emoestudio/Single-phase-AC-electronic-load/电赛提高指标的方法.md

# 电赛目标参数

1. 降低功率到3W内
   1. 换开关频率 区别不大，在波动范围内
   2. 改PI参数 极限了
   3. 屏幕亮度
   4. 换MOS
   5. 辅电 想隔离，还是算了
   6. 电感 已经改了
   7. 降低CPU主频 降了一点点，发现增大THD，还是算了
2. 输入电流THD恒小于3%
   1. 改PI参数
3. PF 0.999
4. PF可调并且较为准确
5. PF范围宽
6. CC、CR、CP
