emoestudio/Single-phase-AC-electronic-load/Code/目标.md

1. 进入工况，在工况下来一遍测试。
2. 计算校正数组理论值
3. 做显示
4. 做键盘
5. 做测量显示功能对应的那些参数
6. 对校正数组值进行校正，对所有adc进行校正
