emoestudio/Single-phase-AC-electronic-load/Code/Core/Src/main.c

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
/* Includes ------------------------------------------------------------------*/
#include "main.h"
#include "adc.h"
#include "dac.h"
#include "dma.h"
#include "tim.h"
#include "usart.h"
#include "gpio.h"

/* USER CODE BEGIN Includes */
#include "arm_math.h"
/* USER CODE END Includes */


void SystemClock_Config(void);
/* USER CODE BEGIN 0 */
extern uint32_t ADC_Value[];
extern pid_p PLL,pid_Udc,pid_I1d,pid_I1q;
extern int flag_Start_Running;
extern float thetas;
/* USER CODE END 0 */

/**
  * @brief  The application entry point.
  * @retval int
  */
int main(void)
{
  /* MCU Configuration--------------------------------------------------------*/

  /* Reset of all peripherals, Initializes the Flash interface and the Systick. */
  HAL_Init();

  /* Configure the system clock */
  SystemClock_Config();

  /* Initialize all configured peripherals */
  MX_GPIO_Init();
  MX_DMA_Init();
  MX_ADC1_Init();
  MX_TIM1_Init();
  MX_TIM2_Init();
  MX_DAC_Init();
  MX_USART1_UART_Init();
  MX_TIM8_Init();
  /* USER CODE BEGIN 2 */

  HAL_Delay(1000);
	printf("BL(0);\r\n");
	HAL_Delay(40);

//  Keyboard_Init();


  //TIM中断控制程序打开
  HAL_TIM_Base_Start_IT(&htim2);
  //ADC
  HAL_ADC_Start_DMA(&hadc1, (uint32_t*)&ADC_Value, ADC_num);

  HAL_DAC_Start(&hdac, DAC_CHANNEL_1);

  //注意KPKI 在幅值为1时根据Simulink得到对应的是314 1725，可以根据此来定
  //20Vp Vs 20 100, Reset 才能正常使用10V时，就做了延�????????
  PID_init(&PLL,20,180,0,500,100,314,Control_Time);

  //通过验证锁相成功后再打开 在TIM1中断
//  PID_init(&pid_Udc,0.3555f,39.934f,0,10,-10,0,1/Control_Frequency);
//  PID_init(&pid_Isd,0.4632f,40.0f,0,10,-10,0,1/Control_Frequency);
//  HAL_TIM_PWM_Start(&htim1, TIM_CHANNEL_1);
//  HAL_TIM_PWM_Start(&htim1, TIM_CHANNEL_2);
//  HAL_TIMEx_PWMN_Start(&htim1,TIM_CHANNEL_1);
//  HAL_TIMEx_PWMN_Start(&htim1,TIM_CHANNEL_2);

//	HAL_TIM_PWM_Start(&htim8, TIM_CHANNEL_1);
//	HAL_TIM_PWM_Start(&htim8, TIM_CHANNEL_2);
//	HAL_TIMEx_PWMN_Start(&htim8,TIM_CHANNEL_1);
//	HAL_TIMEx_PWMN_Start(&htim8,TIM_CHANNEL_2);
  /* USER CODE END 2 */

  /* Infinite loop */
  /* USER CODE BEGIN WHILE */
  while (1)
  {
    /* USER CODE END WHILE */

    /* USER CODE BEGIN 3 */
	  Screen_Print();
  }
  /* USER CODE END 3 */
}

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
