emoestudio/Single-phase-AC-electronic-load/Code/Core/Inc/eva_adc.h

/*
 * eva_adc.h
 *
 *  Created on: Jul 25, 2022
 *      Author: EVA
 */

#ifndef INC_EVA_ADC_H_
#define INC_EVA_ADC_H_

#define ADC_num 8
void ADC_To_adx();
void ADC_ad5_avg_Get();
void ADC_Real_Value_Get();
void ADC_Queue_Save();
void ADC_Sine_Calculate();
void ADC_Park_Transform();
void ADC_Paremeters_Calc();
void ADC_DAC_get_and_show();

#endif /* INC_EVA_ADC_H_ */
