emoestudio/Single-phase-AC-electronic-load/Code/Core/Inc/eva_key.h

/*
 * eva_key.h
 *
 *  Created on: Jul 25, 2022
 *      Author: EVA
 */

#ifndef INC_EVA_KEY_H_
#define INC_EVA_KEY_H_

#include "main.h"

void Key_Clock();
void Key_Detect();

#endif /* INC_EVA_KEY_H_ */
