emoestudio/Single-phase-AC-electronic-load/Code/Core/Inc/eva_paremeters.h

/*
 * ParemetersOfACDCSinglePhase.h
 *
 *  Created on: 2022年7月14日
 *      Author: EVA
 */

#ifndef INC_EVA_PAREMETERS_H_
#define INC_EVA_PAREMETERS_H_

/*一些离散导致的数学时间参数*/
#define APB1_Timer_Clock (80e6)
#define Tim1_Pre (10)
#define Tim1_ARR (400)
#define Tim8_ARR (800)
#define PWM_Output_Frequency (20e3)
#define Double_PWM_Frequency  (40e3)
#define Control_Frequency (20e3)
#define Control_Time (50e-6)
#define ADCTimesEachCycle (400.0f)






#endif /* INC_EVA_PAREMETERS_H_ */
