emoestudio/Single-phase-AC-electronic-load/Code/Core/Inc/eva_screen.h

/*
 * screen.h
 *
 *  Created on: Jul 20, 2022
 *      Author: EVA
 */

#ifndef INC_EVA_SCREEN_H_
#define INC_EVA_SCREEN_H_
void Screen_Init();
void Screen_Print();
void Screen_Fresh_Detect();
void Screen_Clock();
#endif /* INC_EVA_SCREEN_H_ */
