emoestudio/Single-phase-AC-electronic-load/Code/Core/Inc/eva_value_set.h

/*
 * eva_value_set.h
 *
 *  Created on: 2022年7月28日
 *      Author: EVA
 */

#ifndef INC_EVA_VALUE_SET_H_
#define INC_EVA_VALUE_SET_H_

#define Sqrt2 (1.4142f)

void Control_Value_Set();


#endif /* INC_EVA_VALUE_SET_H_ */
