emoestudio/Single-phase-AC-electronic-load/Code/ACDC_Week4_Test.ioc

Mcu.UserName=STM32F407VETx
PA1.Signal=GPIO_Output
PA10.Signal=USART1_RX
PA2.Signal=ADCx_IN2
PA3.Signal=ADCx_IN3
PA4.Signal=COMP_DAC1_group
PA5.Signal=TIM8_CH1N
PA6.Signal=ADCx_IN6
PA7.Signal=ADCx_IN7
PA8.Signal=GPIO_Input
PA9.Signal=USART1_TX
PB0.Signal=ADCx_IN8
PB1.Signal=ADCx_IN9
PB12.Signal=GPIO_Input
PB13.Signal=GPIO_Input
PB14.Signal=TIM8_CH2N
PC4.Signal=ADCx_IN14
PC5.Signal=ADCx_IN15
PC6.Signal=S_TIM8_CH1
PC7.Signal=S_TIM8_CH2
PD0.Signal=GPIO_Input
PD1.Signal=GPIO_Input
PD2.Signal=GPIO_Input
PD3.Signal=GPIO_Input
PE10.Signal=TIM1_CH2N
PE11.Signal=S_TIM1_CH2
PE2.Signal=GPIO_Input
PE3.Signal=GPIO_Input
PE4.Signal=GPIO_Input
PE5.Signal=GPIO_Input
PE8.Signal=TIM1_CH1N
PE9.Signal=S_TIM1_CH1
PH0-OSC_IN.Signal=RCC_OSC_IN
PH1-OSC_OUT.Signal=RCC_OSC_OUT
