emoestudio/Single-phase-AC-electronic-load/(commit log)

2024-01-28 一些方法
2024-01-28 报告 带能量回馈的单相交流电子负载
